malipek/esp8266_utility_meter_mon/(commit log)

2024-01-14 corrected image name for MOSFET solution
2024-01-16 Sensor modified to generates spikes, dirty hack removed from code
